wenzellabs/the_NSA_selector/sabotageakt/README.md

# Sabotageakt

scripts turning the NSA selector into a MIDI device.

see
https://www.youtube.com/watch?v=EaDcG5xgVYs

see also
https://github.com/nstarke/nsa-midi
