wenzellabs/the_NSA_selector/frontpanel/frontpanel_dimensions.png

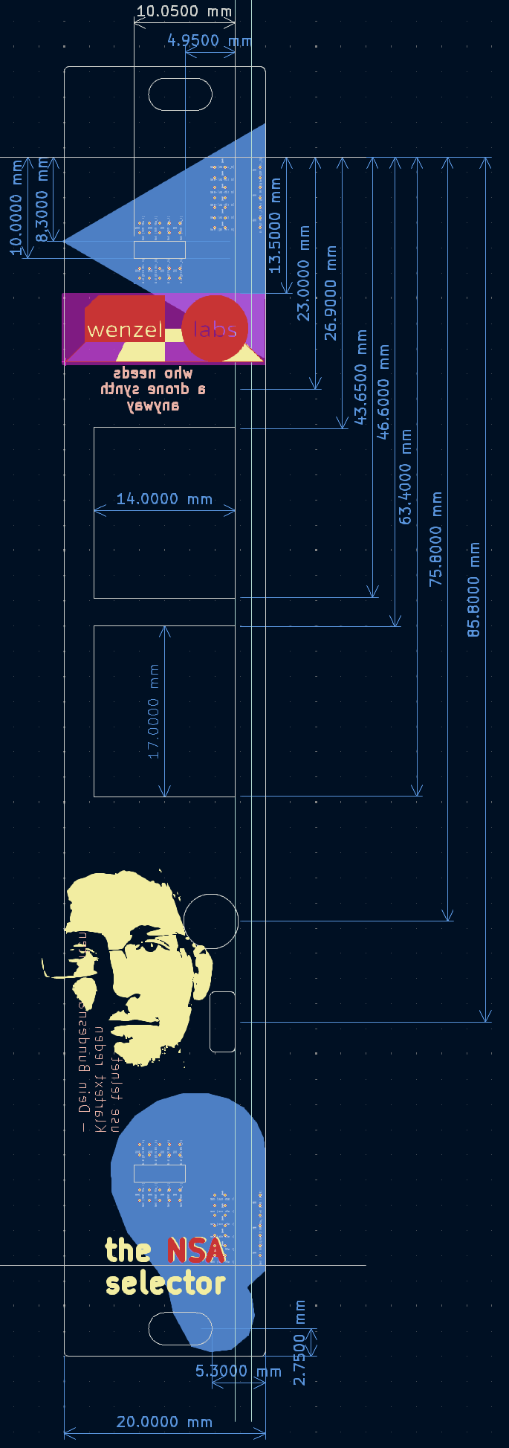
frontpanel/frontpanel_dimensions.png
