wenzellabs/the_NSA_selector/(commit log)

2025-05-21 add latest produced frontpanel from KiCAD8
    [NSA_FP_v02.kicad_pcb, NSA_FP_v02.kicad_sch]
2025-05-21 bump to KiCAD9
    [NSA_FP_v02.kicad_pcb, NSA_FP_v02.kicad_sch]
2025-05-21 document the nasty nasty nasty bottom hole
    [NSA_FP_v02.kicad_pcb]
2025-05-23 depth: 55mm
2025-05-23 frontpanel: new logo, smaller rectangularish bottom hole
    [NSA_FP_v03.kicad_pcb, NSA_FP_v03.kicad_sch]
2025-06-05 add frontpanel_dimensions.png
    [NSA_FP_v03.kicad_pcb]
2025-10-13 sabotageakt: add a default.json sample file
